Binomial-distribution/nascent/docs/implementation/codex-plans/README.md

# Codex B 层实施计划归档

这些文件来自本机 GPT Codex 会话，按时间从新到旧大致为：

| 文件 | 主题 |
|---|---|
| [`PR6-评审修复与页面层级定稿.md`](PR6-评审修复与页面层级定稿.md) | PR #6 Review 与身体笔记页面层级 |
| [`PR6-心率接入与身体笔记身心总结.md`](PR6-心率接入与身体笔记身心总结.md) | Health Connect 心率与身心三段总结（后续 PR） |
| [`B层信息架构纠正与完整纵向实现.md`](B层信息架构纠正与完整纵向实现.md) | 情景漫游 / 我的节奏拆分与完整 UI（后续 PR） |
| [`Android-心绪与亲密时刻框架.md`](Android-心绪与亲密时刻框架.md) | 历史 Flutter Android 骨架 |
| [`心绪与亲密时刻软件框架.md`](心绪与亲密时刻软件框架.md) | 历史 Flutter 三层导航骨架 |

当前口径以 [`../B层完整软件实施计划-B3.0.md`](../B层完整软件实施计划-B3.0.md) 和 [`../../architecture/B层完整版技术文稿-双模型与偏好闭环.md`](../../architecture/B层完整版技术文稿-双模型与偏好闭环.md) 为准。
