Binomial-distribution/nascent/docs/architecture/Web-UI-悬置项.md

# Web UI 悬置项

记录 Web UI（`software/app/`）联调中已确认、但**暂不实现**的改动。实现前需使用者明确要求。

更新日期：2026-08-28

## 悬置清单

1. **我的节奏：温度 slider**  
   在控制页加入温度相关调节（具体交互与协议字段待确认）。

2. **我的节奏：强度上限改为 9**  
   - 档位上限改为 9  
   - 去掉「8 档 / 原产品九档」一类说明文案  
   - 将「停止后如何恢复」迁入「我的节奏」（从「我的」设置中已移除的入口）

3. **情境漫游入口 → AI 伴侣人设**  
   亲密时刻里「情境漫游」入口改为进入 AI 伴侣人设 / 人设设置。

4. **亲密时刻：顶部半透明悬浮设备条**  
   曾尝试后按要求回退为页内设备状态条；待亲密时刻整体更新后再对齐心绪侧悬浮条体验。

## 说明

- 当前主设备 / 健康手环「已连接」文案含默认电量 100%，与心绪、亲密时刻共用 `deviceStatusText` / `statusBar`；亲密时刻悬浮条仍属悬置第 4 项。
- 不要在未获明确授权时把本清单当作待办自动开工。
