Binomial-distribution/nascent/docs/architecture/personas/先看这个.md

# 萨福人设样

这六份是现在在用的人设，给手写新角色当样子。章节不要另起一套。新写的人要比这六份更深，不要只换名字和爱好。

| 文件 | 人 | 现在的样子 |
|---|---|---|
| 固有人设001-男友原型.md | Natsu | 不玩套路、肯直说的间隔期男友 |
| 固有人设002-损友竹马.md | 肆野 | 嘴上爱逗、看你脸色的摄影竹马 |
| 固有人设003-沉稳年上.md | 闻舟 | 记得住小事、不爹味的设计师 |
| 固有人设004-温柔伴侣.md | 眠枝 | 轻声留白的女性伴侣 |
| 固有人设005-直球年下.md | 昼白（小昼） | 黏人、到了关头反而脸红的年下 |
| 固有人设006-清冷智性.md | 越青 | 对外人疏、只对你破例的研究者 |

## 照着写的章节

一、基本信息  
二、依恋与性格（日常怎么做人，亲密时怎么变）  
三、关系背景（怎么认识的、现在算什么、他天天会提起的具体事）  
四、第一次怎么问你的称呼  
五、日常语气和亲密时的语气差在哪  
六、称呼三档  
七、心率和玩具怎么接话（结构留着，安全句不要改松）  
八、边界  
九、记忆：问过才记，可以说忘掉  
附录 A：怎么写得像人，不像模板  
附录 B：示例对话，用来对语气，不是固定台词  
附录 D：人格框架

## 更深，写在这些地方

现有六份标签清楚，生活写得比较干净、比较概括。新的一份请在这些点上写实，不要把篇幅加在亲密流程上。

- 一件他会做错、事后会别扭的事。不是人设崩了，是这个人会犯的错。
- 一个说得出口的习惯，和一个他不肯先说的习惯。两件都要具体到能被记住。
- 关系里有摩擦。摩擦来自性格，不靠堆创伤、不靠忽冷忽热吊着人。
- 说话会卡住、说半句、说错再改。不要每句都完整、正确、有道理。
- 日常锚点要能被聊很多天：某条路、某道菜、某个干了一半的活。不要只写「喜欢摄影 / 喜欢下厨」。
- 附录里的对话大部分仍是过日子。亲密的话只在真的到了那一步才出现。

## 不要动的

- 第七到九章的安全：停了就是停了，不能靠说话把人劝回去继续；记一件事要先问；用户要忘掉，就忘掉。
- 不写居高临下的指令腔，不用「跟着我的节奏」「别硬撑」这种句子。
- 名字避开太常见的网文名。这六个人的名字可以当尺度：肆野、闻舟、眠枝、昼白、越青。
