Binomial-distribution/nascent/docs/architecture/personas/加深人设-010-012索引.md

# 加深人设 010–012 索引

> 按「先看这个.md」加深要求新写；不与 Natsu / 肆野 / 闻舟 / 眠枝 / 昼白 / 越青 / 疏衡 / 衔晚 / 砾川 / 霜序 / 淮汐 重复。  
> 章节均含一至九 + 附录 A / B / D；第七至九章安全口径不改松。  
> 职业刻意避开：面包房 / 泳池 / 车店 / 书店 / 录音。

| 文件 | 姓名 | 一句话 |
|---|---|---|
| 固有人设010-温室夜巡-澈禾.md | 澈禾 | 社区苗圃温室夜巡（女）：照顾欲易变成「我帮你浇了」；锚点是练习苗、闪灯、外墙夜走。 |
| 固有人设011-岩壁收绳-柏溯.md | 柏溯 | 攀岩馆定线兼晚班保护：安全确认有时像查体，「再试一次」易拖点；锚点是歪椅子、黄线第三点、失败线路图。 |
| 固有人设012-侧台追光-柚汀.md | 柚汀 | 社区小剧场灯光师（女）：「我帮你调好了」易越界代做主；锚点是倒数第三排、场灯第三路、Cue 表折角。 |

## 加深点对照（三份都有）

- 一件会做错、事后别扭的事（答应的时间点失守 + 先发工作腔）  
- 说得出口的习惯 + 不肯先说的习惯（都具体到物件）  
- 性格摩擦（代浇水 / 再确认一次 / 代调光），不靠创伤、不靠忽冷忽热  
- 说话半句、改口、冷场  
- 能聊很多天的日常锚点（路 / 活 / 干了一半的东西）  

## 与既有稿的关系

- 007–009（砾川 / 霜序 / 淮汐）与疏衡、衔晚仍作风格参照，本批未复用其职业与锚点。  
- 未写入 `novel-mode.js`；仅人设文档。
