Binomial-distribution/nascent/docs/implementation/codex-plans/PR6-评审修复与页面层级定稿.md

# PR #6 评审修复与页面层级定稿

> 归档来源：本机 GPT Codex 实施计划（2026-08-28）。历史方案，不以本文件覆盖 B3.0 权威规格。

## Summary

在当前分支 `feat/body-notes-insight` 上修复 PR #6 的全部评审问题，并按最新要求调整身体笔记页面。情景漫游本次只完善技术文档和页面契约，不在这个已经较大的 PR 中继续扩展完整 UI。

完成后运行完整检查，提交并推送到 PR #6，不合并 PR。

## Key Changes

### 身体笔记

- 保持三级结构：`记录列表 → 记录详情 → 微信式了解自己对话`。
- 记录详情改为单页纵向布局：
  - 顶部展示本次日期、模式、时长、数据质量和事实摘要。
  - 接着展示本次档位、压力和温感可视化。
  - 下方直接展示最近最多 5 次有效记录的对比图表和聚合总结。
  - 数据不足时显示明确说明，不推断偏好。
- 移除“只看这一次”和“参考近期记录”两个固定按钮及额外范围选择弹窗。
- 页面底部只保留一个“了解自己”入口。
- 点击入口即授权 Chat 9B 读取页面上明确列出的本次记录和近期记录；聊天页持续显示具体来源。
- 修复启动竞态：
  - 有后端请求能力时，加载完成前状态保持“未确定”。
  - 加载或后端状态未确定时，删除、保存发现和发起洞察等修改操作全部失败关闭。
  - UI 同步禁用相关按钮并显示加载状态。
  - 纯静态演示明确标记为离线状态，仍允许仅修改内存数据。
  - 后端加载完成后不能覆盖加载期间的本地操作，也不能让已删除记录复活。
- 所有模式名称统一通过安全回退获取，未知模式按 `free` 展示，避免 `MODE_UI[item.mode]` 抛出异常。

### B 层契约与后端

- 统一 Skill 契约：
  - 模板和 Chat Skill 使用 `rhythm_segment`、`set_pattern`。
  - `hold_current` 只属于 Control 9B 的控制决策，不作为模板硬件 Skill。
  - 文档不再把设备协议命令 `set_level` 当作 Agent Skill。
- 统一双模型名称：
  - `nascent-chat-9b` 是 Chat 逻辑角色别名。
  - `nascent-control-9b` 是 Control 逻辑角色别名。
  - 两者初期均可映射到供应商模型 `Qwen/Qwen3.5-9B`，但使用独立配置和超时。
  - `nascent-realtime-9b` 标记为已废弃的旧口径，不再用于新流程。
- 修复 `generate_control()`：
  - `hold` 决策保留模型原有 `reason_codes`。
  - `hold` 携带的 Skill、档位、Pattern 等建议字段全部清空。
  - 只有 `recommend` 决策才检查模板 Skill 白名单。
  - 不允许的推荐降级为 `hold + skill_not_allowed`。
  - 所有结果继续强制 `action=null`，不能直接生成设备命令。
- 重构身体洞察过滤：
  - 保留设备控制、医疗诊断和确定性偏好断言的禁止规则。
  - 删除对“固定偏好”的宽泛子串封禁。
  - 禁止“说明你喜欢”“证明你”“你一定”等确定性断言。
  - 允许“不代表固定偏好”等否定性安全说明。
  - 本地安全回退也必须经过 `BodyInsightModelOutput` 契约验证，不能绕过校验器。
- `/v1/agent/memory` 的 `limit` 使用 FastAPI 参数约束为 `1..20`，非法值返回 `422`；内存 Provider 再做一次防御性限制。

### 情景漫游文档层级

情景漫游入口页明确只有三个并列按钮：

1. `选择已有人设`
   展示以前创建或保存的人设；点击某个人设直接进入独立情景聊天页。
2. `定义人设`
   使用结构化表单设置名称、风格、语气和允许的 Skill；确认创建后直接进入情景聊天页。
3. `对话创建人设`
   进入专门的人设创建对话；生成并确认人设后，再跳转到真正的情景聊天页。

人设创建对话与实际情景使用必须是不同页面和路由。实际使用页采用类似微信的消息气泡界面，包含人设信息、连接状态、对话、语音入口和脱敏数据走向，但这部分 UI 编码留到后续独立短分支。

### 文档、缓存与 CI

- 更新 B 层架构文档、Prompt 契约、语音方案、后端 README 和 `.env.example` 注释，使 Skill、模型别名和删除接口一致。
- 删除接口文档以当前 `/v1/agent/...` 和 `/v1/body-notes/...` 为已实现接口；会话级删除草案明确标记为未来规划。
- Service Worker 缓存升级版本，并在 `activate` 阶段删除旧的 `nascent-shell-*` 缓存。
- 新增 GitHub Actions：
  - Python 3.11、Node.js 20。
  - 安装 `software/backend/requirements.txt`，确保 `pytest-asyncio` 存在。
  - 配置异步 fixture loop scope，避免 pytest 警告和异步测试静默跳过。
  - 执行前端 Node 测试、全部后端测试、Ruff、compileall、协议生成检查和 diff 检查。
- 实施文档记录 PR #6 修复结果，并将飞书 revision 91 同步列为合并后的待办，不声称仓库和飞书当前完全同步。

## Interfaces And Tests

- `GET /v1/agent/memory?limit=`：仅接受 `1..20`。
- 身体笔记不新增后端路由，继续使用显式 `session_id` 和 `comparison_session_ids`。
- 不修改 `protocol/contract.yaml`，因为本轮没有新增设备跨端字段。
- 新增回归测试：
  - 加载未完成时删除被拒绝，本地记录不消失。
  - 加载完成后删除必须调用后端，记录不会复活。
  - 无 Fetch 的静态演示仍支持本地删除。
  - `hold` 保留原因并清空非法推荐字段。
  - 非法 `recommend` 降级为 `skill_not_allowed`。
  - “不代表固定偏好”通过校验，确定性偏好断言被拒绝。
  - 本地洞察回退通过相同输出契约。
  - 负数、零和超过上限的记忆查询参数得到正确结果。
  - 未知会话模式不会导致详情页或聊天页崩溃。
- 浏览器验收覆盖 360×800 手机视口和桌面视口：详情页顺序正确、近期图表可见、只有一个“了解自己”入口、聊天来源清晰且无横向溢出。

## Git Delivery

- 在 `feat/body-notes-insight` 上显式暂存本次文件。
- 提交信息：`fix: address PR 6 review feedback`
- 推送到现有远程分支，更新 Draft PR #6。
- 在 PR 中回复每一项评审问题、测试结果和未实现的情景漫游 UI 范围。
- 不自动合并 PR。
