Binomial-distribution/nascent/hardware/toy-sidecar/docs/schematic.png

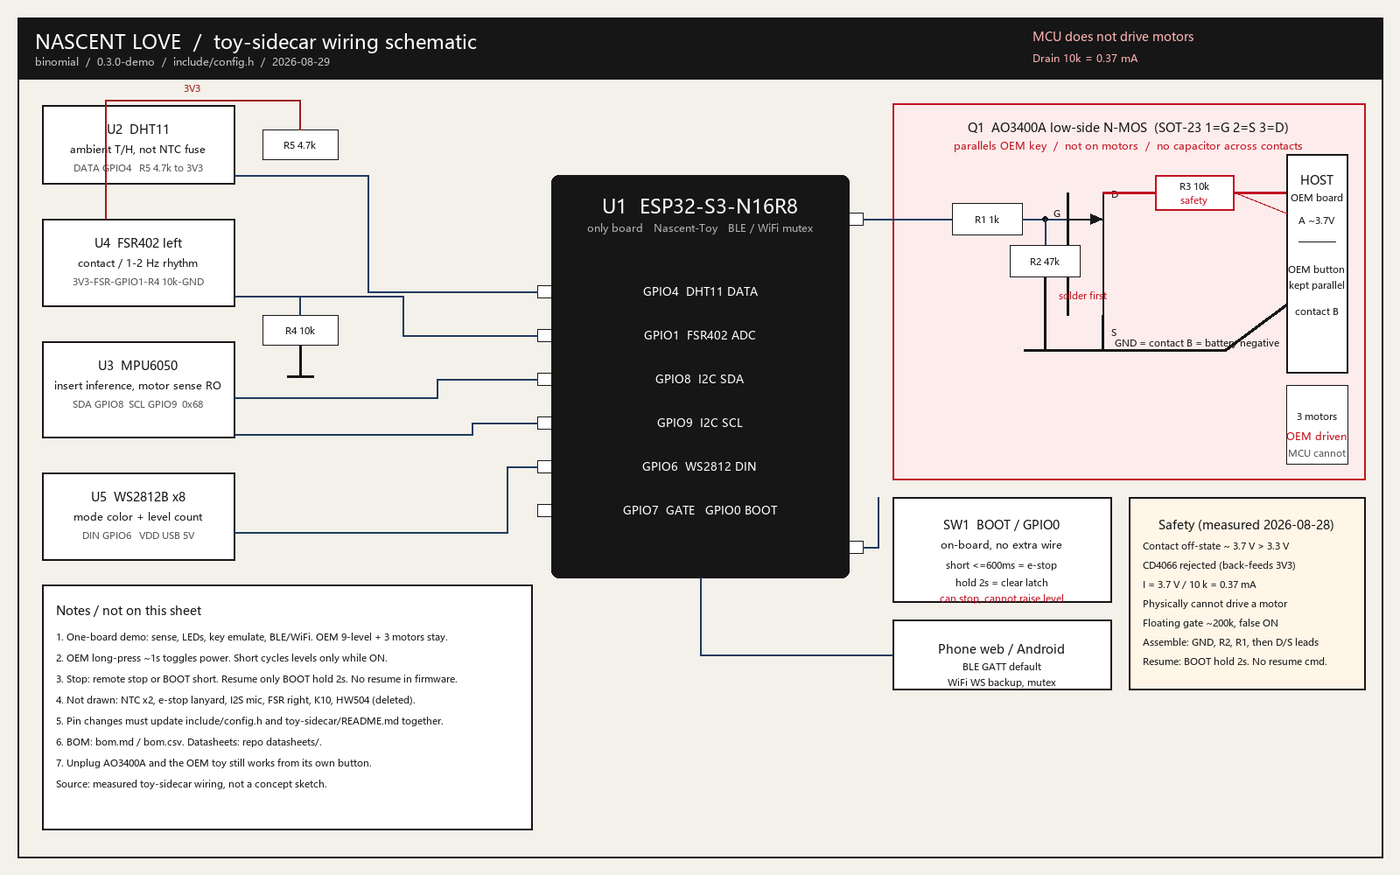
hardware/toy-sidecar/docs/schematic.png
