Binomial-distribution/nascent/www/img/hero-portrait.png

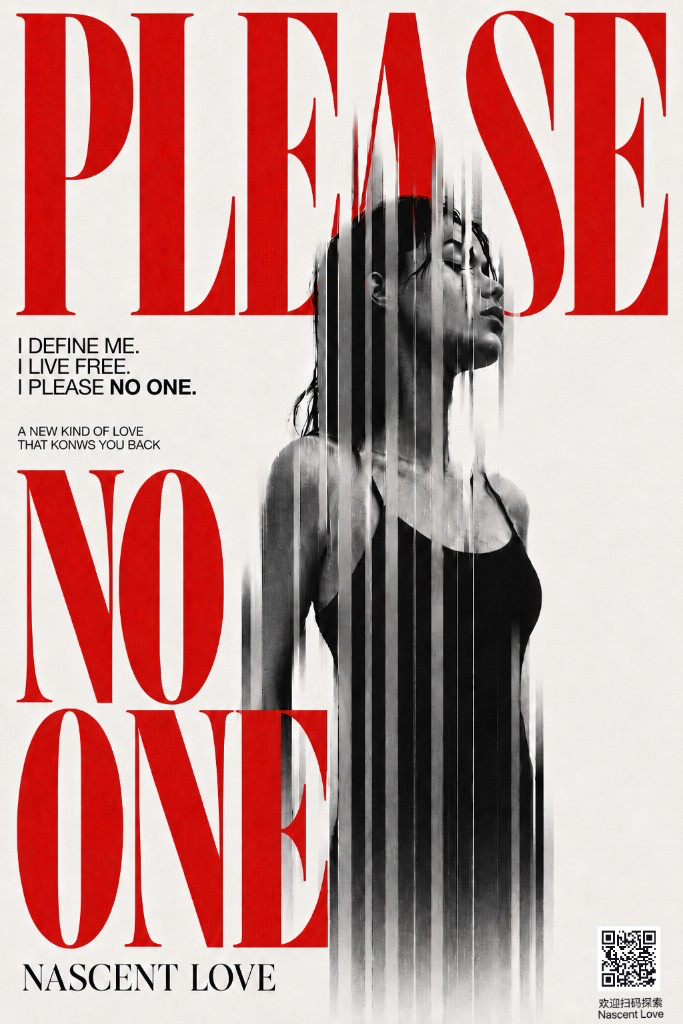
www/img/hero-portrait.png
