Binomial-distribution/nascent/hardware/toy-sidecar/docs/bom.md

# Nascent Love 验证期 BOM

团队 **binomial** · 项目 **Nascent Love** · 板卡 `hardware/toy-sidecar` · 协议 `0.3.0-demo`

验证期只有一块板：ESP32-S3-N16R8。它采集、推断、点灯，经 AO3400A 并联原产品按键；**不驱动电机**。电机、九档逻辑、实体按键都还在原产品控制板上。

单价为 2026-08 国内散件参考价（人民币），不含原产品本体。CSV 源：[`bom.csv`](bom.csv)。接线原理图：[`schematic.svg`](schematic.svg)。

## 采购件

| # | 位号 | 数量 | 型号 / 规格 | 封装 | 参考单价 | 小计 | 用途与约束 |
|---|---|---|---|---|---|---|---|
| 1 | U1 | 1 | ESP32-S3-N16R8 开发板（16MB Flash / 8MB PSRAM / USB-C） | DevKit | 48.00 | 48.00 | 玩具侧唯一主控。广播名 `Nascent-Toy`。板载 BOOT = GPIO0 |
| 2 | U2 | 1 | DHT11 温湿度模块 | 模块 | 4.00 | 4.00 | GPIO4 单总线。只做玩具环境温湿度，不参与接触熔断 |
| 3 | U3 | 1 | MPU6050（GY-521）六轴 | 模块 | 9.00 | 9.00 | I2C GPIO8/9，地址 0x68。入体推断；电机观测只读、永不驱动按键 |
| 4 | U4 | 1 | FSR402 圆膜压力 | 薄膜 | 22.00 | 22.00 | GPIO1 ADC。3V3—FSR—ADC—10k—GND。不做高潮检测 |
| 5 | U5 | 1 | WS2812B ×8 | 灯板 | 10.00 | 10.00 | GPIO6 RMT。建议 5V 供电。档位 = 点亮颗数 |
| 6 | Q1 | 1 | AO3400A 30V N-MOS | SOT-23 | 0.80 | 0.80 | 低边开关并联原按键。引脚 1=G / 2=S / 3=D |
| 7 | R1 | 1 | 1kΩ ±5% 1/8W | 直插 | 0.05 | 0.05 | GPIO7 到栅极串联 |
| 8 | R2 | 1 | 47kΩ ±5% 1/8W | 直插 | 0.05 | 0.05 | 栅极下拉。必须先于触点飞线焊接 |
| 9 | R3 | 1 | 10kΩ ±5% 1/8W | 直插 | 0.05 | 0.05 | **安全件**：漏极限流，支路 ≤0.37mA。不可省、不可减小 |
| 10 | R4 | 1 | 10kΩ ±5% 1/8W | 直插 | 0.05 | 0.05 | FSR402 下拉 |
| 11 | R5 | 1 | 4.7kΩ ±5% 1/8W | 直插 | 0.05 | 0.05 | DHT11 上拉；模块已带则可省 |
| 12 | W1 | 1 | 飞线 / 杜邦线 | 套 | 6.00 | 6.00 | 原按键触点走焊接飞线，不要走面包板 |
| 13 | J1 | 1 | USB-C 数据线 | 线材 | 8.00 | 8.00 | 供电与烧录 |
| 14 | SW1 | 1 | BOOT 键 | 板载 | 0 | 0 | 短按急停，长按 2s 解闩锁。无需外购外接 |

**电子件小计约 ¥108。** 不含原产品本体。

## 宿主（不采购进本 BOM）

| 位号 | 名称 | 说明 |
|---|---|---|
| HOST | 萨福入体震动棒原产品 | 原控制板九档逻辑 + 实体按键 + 三路振动。本板只并联按键。摘掉 AO3400A 支路后原产品仍可独立使用 |

## 验证期未焊（量产项，不要按本表采购来演示）

| 器件 | 原因 |
|---|---|
| NTC ×2（接触面 + 外壳） | 12Hz 接触过温熔断。Demo 未焊；DHT11 不能替代 |
| FSR402 右（GPIO2） | `TOY_HAS_FSR_R=0`，固件不读 |
| 常闭急停拉环 | Demo 用板载 BOOT 键短按代劳 |
| I2S 麦克风 | 本地安全词。Demo 可不焊 |
| HW504 摇杆 / 行空板 K10 | 协议 0.3.0 已删除，不要再买 |

## 引脚（与 `include/config.h` 一致）

| 功能 | 引脚 | 外围 |
|---|---|---|
| DHT11 DATA | GPIO4 | R5 4.7k 上拉到 3V3 |
| FSR402 左 | GPIO1 | R4 10k 下拉到 GND |
| FSR402 右 | GPIO2 | 未接 |
| WS2812B DIN | GPIO6 | 灯珠 5V，地与开发板共地 |
| AO3400A 栅极 | GPIO7 | R1 1k 串联 + R2 47k 下拉 |
| MPU6050 SDA | GPIO8 | 模块内部上拉，100kHz |
| MPU6050 SCL | GPIO9 | |
| BOOT | GPIO0 | 板载，不接线 |

AO3400A：漏极经 R3 10k 接原按键触点 A（关机态约 3.7V）；源极接触点 B + 原电池负极 + ESP32 GND（三方共地）。原实体按钮保留并联。

Datasheet 目录：[`../../../datasheets/`](../../../datasheets/README.md)。
