Binomial-distribution/nascent/hardware/toy-sidecar/src/ble_peripheral.cpp

#include "ble_peripheral.h"

#include <Arduino.h>
#include <BLE2902.h>
#include <BLEDevice.h>
#include <BLEServer.h>
#include <BLEUtils.h>

namespace {

BLEServer *g_server = nullptr;
BLECharacteristic *g_uplink = nullptr;
BLECharacteristic *g_downlink = nullptr;
BLECharacteristic *g_info = nullptr;
BlePeripheral *g_self = nullptr;

}  // namespace

class NlServerCallbacks : public BLEServerCallbacks {
  void onConnect(BLEServer *) override { g_self->handleConnect(millis()); }
  void onDisconnect(BLEServer *server) override {
    g_self->handleDisconnect();
    // 必须重开广播，否则断一次就再也连不上。
    // 注意这**不代表**断连无害：up() 会立刻转 false，安全总督随即归零。
    // 重开广播只是让人能连回来，不是让输出继续。
    server->startAdvertising();
  }
};

class NlDownlinkCallbacks : public BLECharacteristicCallbacks {
  void onWrite(BLECharacteristic *ch) override {
    // 2.x 返回 std::string，3.x 返回 Arduino String，两者都有 c_str/length。
    auto v = ch->getValue();
    g_self->handleWrite(v.c_str(), v.length(), millis());
  }
};

bool BlePeripheral::begin(CommandHandler handler) {
  if (started_) return true;
  handler_ = handler;
  g_self = this;

  BLEDevice::init(NL_BLE_DEVICE_NAME);
  // contract 的 min_mtu=185 是下限，不是上限。一帧 BleUplink JSON 大约 210 字节，
  // ATT 载荷还要扣 3 字节：把本地 MTU 钉在 185，协商结果就装不下，notify 会失败，
  // 于是 App 只拿到 Info 令牌、永远看不到遥测。ESP32 允许的上限是 517。
  BLEDevice::setMTU(517);

  g_server = BLEDevice::createServer();
  g_server->setCallbacks(new NlServerCallbacks());

  // 三个特征加上 CCCD 描述符，默认的 15 个句柄不够用。
  BLEService *svc = g_server->createService(BLEUUID(NL_BLE_SERVICE_UUID), 32, 0);

  // Notify 是正路。Windows Chrome 有时订了 CCCD 仍不推事件，可读一次最新值作退路。
  g_uplink = svc->createCharacteristic(
      NL_BLE_UPLINK_UUID,
      BLECharacteristic::PROPERTY_NOTIFY | BLECharacteristic::PROPERTY_READ);
  g_uplink->addDescriptor(new BLE2902());

  g_downlink = svc->createCharacteristic(NL_BLE_DOWNLINK_UUID, BLECharacteristic::PROPERTY_WRITE);
  g_downlink->setCallbacks(new NlDownlinkCallbacks());

  g_info = svc->createCharacteristic(NL_BLE_INFO_UUID, BLECharacteristic::PROPERTY_READ);

  svc->start();
  publishInfo();

  BLEAdvertising *adv = BLEDevice::getAdvertising();
  adv->addServiceUUID(NL_BLE_SERVICE_UUID);
  adv->setScanResponse(true);
  BLEDevice::startAdvertising();

  started_ = true;
  Serial.printf("[ble] 广播 %s，服务 %s\n", NL_BLE_DEVICE_NAME, NL_BLE_SERVICE_UUID);
  return true;
}

void BlePeripheral::end() {
  if (!started_) return;
  // 切到 WiFi 之前必须把射频和协议栈整个还掉，否则两栈并存抢时隙。
  BLEDevice::deinit(true);
  g_server = nullptr;
  g_uplink = nullptr;
  g_downlink = nullptr;
  g_info = nullptr;
  started_ = false;
  connected_ = false;
  gate_.endSession();
  Serial.println("[ble] 已停止");
}

void BlePeripheral::tick(uint32_t) {
  // Bluedroid 的连接维护全在它自己的任务里，这里没有要推进的状态。
}

bool BlePeripheral::up(uint32_t) const { return connected_; }

void BlePeripheral::sendUplink(const char *json, size_t len) {
  if (!connected_ || !g_uplink || json == nullptr || len == 0) return;

  uint16_t peer_mtu = 23;
  if (g_server != nullptr) {
    uint16_t m = g_server->getPeerMTU(g_server->getConnId());
    if (m >= 23) peer_mtu = m;
  }
  const uint16_t max_payload = peer_mtu > 3 ? static_cast<uint16_t>(peer_mtu - 3) : 20;
  // peer MTU 仍是 23 时多半还在协商，硬丢会让 Windows 永远等不到第一帧。
  // 已经协商到一个明确偏小的值（例如曾经的 185）才跳过，避免发截断 JSON。
  if (peer_mtu > 23 && len > max_payload) {
    static uint32_t last_warn_ms = 0;
    uint32_t now = millis();
    if (now - last_warn_ms > 2000) {
      last_warn_ms = now;
      Serial.printf("[ble] 上行 %u 字节 > MTU 载荷 %u（peer MTU %u），本帧丢弃\n",
                    static_cast<unsigned>(len), static_cast<unsigned>(max_payload),
                    static_cast<unsigned>(peer_mtu));
    }
    return;
  }

  g_uplink->setValue(reinterpret_cast<uint8_t *>(const_cast<char *>(json)), len);
  g_uplink->notify();
  static bool logged_ok = false;
  if (!logged_ok) {
    logged_ok = true;
    Serial.printf("[ble] 首帧上行已 notify，%u 字节，peer MTU %u\n",
                  static_cast<unsigned>(len), static_cast<unsigned>(peer_mtu));
  }
}

void BlePeripheral::handleConnect(uint32_t now_ms) {
  connected_ = true;
  gate_.newSession(now_ms);
  publishInfo();
  uint16_t peer = g_server ? g_server->getPeerMTU(g_server->getConnId()) : 0;
  Serial.printf("[ble] 手机已连接，已签发新会话令牌；peer MTU %u（本地上限 %u）\n",
                static_cast<unsigned>(peer), static_cast<unsigned>(BLEDevice::getMTU()));
}

void BlePeripheral::handleDisconnect() {
  connected_ = false;
  gate_.endSession();
  Serial.println("[ble] 手机断开");
}

void BlePeripheral::publishInfo() {
  if (!g_info) return;
  char buf[128];
  size_t n = gate_.buildInfo(buf, sizeof(buf));
  g_info->setValue(reinterpret_cast<uint8_t *>(buf), n);
}

void BlePeripheral::handleWrite(const char *data, size_t len, uint32_t now_ms) {
  // 本函数在 Bluedroid 任务里跑。handler_ 只允许把指令丢进信箱，
  // 不能在这里动按键或总督，见 main.cpp 的 CommandMailbox。
  nl_command_t out;
  if (!gate_.accept(data, len, now_ms, out)) return;
  if (handler_) handler_(out);
}
