Binomial-distribution/nascent/hardware/toy-sidecar/src/ao3400.h

// AO3400A 低边 N-MOS：并联原产品的轻触按键。
//
// 边界必须记清楚：
//   - 它只"按按钮"，**不驱动电机**。电机始终由原产品控制板驱动。
//   - 漏极串了 10kΩ，这条支路的电流被封在 0.37mA（3.7V / 10kΩ）。
//     那颗电阻是安全论证的一部分，不是可选件：AO3400A 本体能过 5.7A，
//     拆掉它就等于把"物理上无法驱动电机"这条保证降级成一句口头纪律。
//     原板按键节点是兆欧级高阻输入（实测 200kΩ 即可触发），10kΩ 导通时
//     只在节点上留约 80mV，对功能毫无影响。
//   - 栅极必须有 47kΩ 下拉。浮空栅极实测半导通约 200kΩ，足以误触发开机。
//   - 原实体按钮不拆，手按和软件按并存。
//
// 原板行为模型（2026-08-28 实物实测，不再是假设）：
//   - 长按约 1s = 电源**取反**。关机态长按 → 开机并停在第 1 档；
//     开机态长按 → 关机。它不是单向的"关机键"，这一点决定了整个状态机。
//   - 短按 = 档位循环，**仅开机态有效**；关机态短按原板毫无反应。
//   - 原板不回传任何状态，所以下面的 powered_ / step_ 都是开环假设。
//     唯一可信的已知点是"关机"：一次把它关掉的长按之后，记录才重新对齐。
#pragma once

#include <stdint.h>

class Ao3400 {
 public:
  void begin(uint8_t pin);

  // BLE / WiFi 初始化之后调用：把栅极脚重新声明为输出。
  // 无线电协议栈有时会改 GPIO 复用，外部 3.3V 能触发、固件却拉不动时就是这个。
  void reclaimPin();

  // 每轮主循环调用，推进按键时序状态机。
  void tick(uint32_t now_ms);

  // 请求原板停在第 target 档（1..9，对应协议档位）。0 表示正常关机。
  // 内部自己算怎么按，调用方不需要关心原板当前在哪一档。
  void requestLevel(uint8_t target);

  // 联调用：直接发一次原按键时序，不走开环档位状态机。
  // hold=true 长按约 1.2s（电源取反）；false 点按约 120ms（开机后切一档）。
  void requestRawPress(bool hold);

  // 立即关机。停机路径专用。
  //
  // 注意它在"记录为关机"时**什么都不按**：长按是电源取反，
  // 盲发一次会把用户没要求的输出打开，那是这个产品最坏的失败模式。
  void requestOffNow();

  bool busy() const { return goal_active_ || phase_ != Phase::kIdle; }
  uint8_t assumed_step() const { return step_; }
  bool powered() const { return powered_; }
  bool needs_resync() const { return needs_resync_; }

  // IMU 电机观测器修正开环记录的唯一入口。
  //
  // 它**只改记录，不入队任何按键**。观测不能变成动作：让一个会被
  // 人体动作干扰的信号去直接按电源键，等于把"设备自己动起来"的
  // 权力交给噪声。修正之后，是否真的去按仍由 stop / requestLevel 决定。
  void markObservedPowered(bool on);

  // 开环跟踪难免会跑偏。人工按了实体按钮之后调用这个重新对齐。
  void resync() { needs_resync_ = true; }

 private:
  enum class Phase : uint8_t { kIdle, kPressing, kGap };

  void startPress(bool long_press, uint32_t now_ms);
  void finishPress();

  uint8_t pin_ = 0;
  Phase phase_ = Phase::kIdle;
  uint32_t phase_until_ms_ = 0;
  bool pressing_long_ = false;  // 正在执行的这一下是长按吗，决定时长与效果

  // 目标式而不是队列式：不预先算"要按几下"，而是每按完一下都用最新的
  // 开环状态重新决策。这样新指令半路插进来也不会让次数失配。
  bool goal_active_ = false;
  uint8_t goal_step_ = 0;
  uint8_t press_budget_ = 0;  // 一个目标最多按这么多下，防止跑飞后无限按

  uint8_t step_ = 0;  // 开环假设的原板当前档位，0 = 关机
  bool powered_ = false;
  bool needs_resync_ = false;
  bool raw_queued_ = false;
  bool raw_hold_ = false;

  // 临界区里不能 printf。tick 退出后再打。
  bool log_high_ = false;
  bool log_low_ = false;
};
