Binomial-distribution/nascent/(commit log)

2026-08-27 初始化 Nascent 单仓：协议契约、双板固件、App 与后端骨架
    以 protocol/contract.yaml 为三端唯一事实来源，由 tools/gen.py 生成
    C / Dart / Python 产物并直接投放到各端包内，避免手工同步造成漂移。
    固件的通用驱动一律用社区成熟库，源码 vendored 在 hardware/*/lib/
    （DHTesp、MPU6050、Adafruit_NeoPixel、ArduinoJson），来源与版本记在
    hardware/VENDOR.md。自己写的只有产品独有逻辑：入体推断、灯语优先级、
    CD4066 对原板的按键时序、板间协议。K10 侧的屏幕与按键 API 照着
    DFRobot 官方示例写，示例原件留在 reference/ 下备查。
    安全边界贯穿四层：CD4066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
2026-08-27 docs: 补充协作规范与 AI 入口
    把短分支、显式暂存、协议生成流程和高风险评审写成仓库内规范，
    并用 AGENTS.md 要求开发任务开始前先读这份文档。
2026-08-27 Update Nascent 开发与代码提交规范.md
2026-08-27 docs: 把飞书产品架构归档进仓库
    飞书只作讨论草稿。权威副本放在 docs/architecture/，开发手册约定
    改架构必须同步进本仓库并走 PR，不能只改飞书。
2026-08-28 feat: add heart and intimacy app framework
2026-08-28 docs: record app framework delivery
2026-08-28 fix: 修复评审发现的版本门控与控制页状态问题
    - BLE 版本门控放宽为只校验主版本，0.1.x 旧固件无需重新烧录即可连接；
    VERSION_MINOR 同步为 2 并重新生成三端协议产物
    - 控制页草稿档位在上行确认后交回设备值，停止时立即清除，
    避免设备已停而界面仍显示非零档位
    - 连续记录天数对"今天还没记"留宽限，从昨天开始计数，并补边界测试
    - 空白身体笔记不再提示已保存；情境漫游首次点按停留在首段；
    心绪选择器改为均分宽度避免窄屏溢出
    - 抽取心绪页与亲密时刻页共用的 DeviceStatusBar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
    [contract.yaml]
2026-08-28 docs: 归档飞书心绪层实现与 UI 设计定稿
    - 新增 docs/architecture/心绪层技术实现.md（飞书 revision 2）
    - 新增 docs/architecture/UI设计与用户旅程.md（飞书 revision 8）
    - 产品架构.md 的来源列表链接到仓库内归档副本
    - 软硬件技术架构文档（FggRdEmySofDoGx2WzFc77MznCd）仍为 revision 63，
    与已有归档一致，无需更新
2026-08-28 feat: 控制端改为网站，并加同一套 Web UI 的 App 壳
    网站用 Web Bluetooth 直连行空板；Android App 加载同一页面、走原生 GATT。安全总督仍在浏览器侧。
2026-08-28 docs: 产品架构 V1.3 已反向同步回飞书原文（revision 75）
2026-08-28 fix: 原板按键改为长按取反语义，上电不再盲发长按
    实测原按键：长按约 1s 是电源取反而不是关机，短按只在开机态有效。原来 begin() 里那次"对齐用"的长按会把关着的玩具打开，属于停机路径上的实际风险。状态机改为目标式，每按完一下用最新开环状态重新决策并带按键预算上限，降档走关机再开机以避免绕经原板第 9 档。触点实测 3.7V 超过 3.3V，CD4066 供电冻结为情况 B：原板 3.8V 供电、三方共地、GPIO7 串 1kΩ。另新增只读的 IMU 电机观测器补开环盲区，观测只修正记录与报警、永不驱动按键，阈值待实物标定故默认关闭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
    [cd4066.cpp, cd4066.h, config.h, contract.yaml, main.cpp, motor_sense.cpp, motor_sense.h]
2026-08-28 docs: 记录架构文档反向同步至飞书 revision 91 (#5)
    PR #4 引入的 CD4066 供电定案（情况 B）、按键语义与固件状态机、
    电机观测器章节已写回飞书原文，37 项内容校验全部通过。
2026-08-28 原按键开关器件改为 AO3400A 低边 N-MOS（漏极串 10kΩ 限流） (#7)
    * refactor: 原按键开关由 CD4066 换为 AO3400A 低边 N-MOS
    触点实测 3.7V 高于 3.3V，CD4066 需要供电轨、且会经输入保护二极管往
    ESP32 的 3V3 轨倒灌，整条路线（原「情况 A / 情况 B」）作废。AO3400A
    源极即地，不需要供电轨也没有倒灌路径，栅极天然吃 3.3V 逻辑。
    漏极串 10kΩ 是为了把「本板不驱动电机」这条不变量继续保持在硬件级：
    CD4066 的 10mA 上限原本是物理保证，而 AO3400A 能过 5.7A。原板按键
    节点是兆欧级高阻输入（实测 200kΩ 即可触发），10kΩ 导通时只留约 80mV，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
2026-08-28 docs: 入库 AO3400A 厂商 datasheet，并以规格书修正阈值与导通电阻引用 (#8)
2026-08-28 docs: 记录架构文档反向同步至飞书 revision 127 (#9)
    * feat(protocol): 手机直连玩具侧，删除 K10 与摇杆相关契约
    去掉行空板 K10 与 HW504 摇杆之后，手机直接连玩具侧 ESP32-S3：
    BLE 优先，WiFi WebSocket 备用，两条承载同一份 JSON。
    破坏性变更：cmd 枚举删掉中间的 set_joystick，resume 线序由 6 前移到 5，
    固件与控制端必须同批更新。现场无已发出设备。
    最重要的一条是 resume：手机直连之后，"指令只可能来自 K10 物理按键"这个
    前提消失了。若继续让固件的 onCommand 接受 resume，手机就能远程解除停机
    闩锁——这是全系统最坏的失败模式。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
2026-08-28 docs: 记录规格书数值修正反向同步至飞书 revision 131 (#10)
    PR #8 入库 AO3400A 厂商 datasheet 后按规格书修正的三处引用
    （Vgs(th) 1.05/1.45V、Rds(on) < 48mΩ、datasheet 清单与未决表）
    已同步回飞书原文。
2026-08-28 feat(app): Web UI 设置与 Onboarding，并记录亲密时刻悬置项 (#12)
    完善「我的」安全与隐私/通用设置、安全词与设备电量展示，加入首次引导流；将暂不实现的亲密时刻相关改动写入悬置笔记以便后续接续。
2026-08-28 feat: 去掉行空板，手机直连玩具侧（BLE 默认 / WiFi 备用） (#11)
    * feat(toy-sidecar): WiFi WebSocket 备用通道，与 BLE 运行时互斥
    玩具侧作 STA 接入局域网并起 WebSocket 服务端，承载与 BLE 完全相同的 JSON。
    默认仍优先 BLE；当前通道空闲超过 TRANSPORT_IDLE_SWITCH_MS 且另一条可用才切，
    切过去起不来就退回来。同一时刻只开一条——ESP32-S3 只有一路 2.4GHz 射频，
    共存要靠时分，12Hz 上行会抖，而这条链路上跑着停机指令。
    顺手把下行的鉴权与拒绝规则抽成 downlink_gate，两条传输共用同一份，而不是
    在 WiFi 里再抄一遍 BLE 那 90 行。这些规则就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
2026-08-28 feat: add body notes insight and parallel agents (#6)
    * feat: add B-layer agent and body notes architecture
    * feat: add body notes insight flow
    * docs: adopt B3.0 spec and close PR #6 review findings
    * docs: link B3.0 implementation plan from architecture and README
    * docs: archive Codex B-layer plans alongside the B3.0 spec
    * fix: close leftover PR #6 review gaps in Skill docs and body-note races
    Agent Skill names, model alias mapping, and the two small bugs (load/delete resurrection, insight filter vs stub) now match the code; search_memor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
2026-08-28 feat: 四栏底栏，亲密时刻与身心记录分层 (#15)
    Keep intimacy to scenario personas plus self-control, move body notes onto a records long page, and redirect the old notes routes without merging into PR #6.
2026-08-29 feat(app): onboarding 蓝牙说明与健康手环配对 (#17)
    接上最新 main 后，更新权限页蓝牙文案，并在玩具配对后增加可跳过的健康手环配对；改动说明写入 Web-UI 改动笔记。
2026-08-29 feat: 情景人设改为女性向陪伴，并接上问卷建卡与自然语音
    情景列表改为顾深 / 阿北 / 阿月；问卷与手写建卡；通话先响铃再接通。Chat 每轮带 tts_style，MiniMax 走 emotion，设置页可切小米 MiMo。自定义声线本轮只在本机记下。一并修掉高潮误判、清除本地后对话/人设复活，以及 healthz 的 tts 字段。
2026-08-29 feat(app): onboarding 意图与陪伴者问卷 (#19)
    * feat(app): onboarding 意图与陪伴者问卷，合并经验与人设步骤
    用选择题替换原使用经验文案与自由填写人设，并补上节奏、保养提醒与隐私安心项；同步写入改动笔记，并修复 sw.js 残留冲突标记。
    * fix(app): 产品文案与陪伴者步骤「稍后设置」
    产品页去掉「萨福」字样；陪伴者过渡/性格/节奏均可稍后设置并跳到清洁提醒，清洁页保持必选。
    ---------
2026-08-29 feat(app): 小米手环 7 心率接入（AI 对话，不控机） (#18)
    验证期需要实时 BPM，但心率只能作为对话趋势，不能改 GATT 或调档。
    Android 壳收签名权限广播，网页做平滑与基线后写入已有 sensor_context。
2026-08-29 feat: 设置页给玩具配 WiFi，并准备后端 secrets 目录 (#21)
    非开发者经已鉴权的 set_wifi 写入 NVS，网站/PWA/Android 共用同一套设置页。
    部署密钥约定放到 software/backend/secrets/，真实密钥不进仓库。
2026-08-29 feat: 硬件联调页与玩具侧验板 (#23)
    * checkpoint before checking out chore/hw-local-config
    * feat(app): 将硬件联调入口放到「我的」最下方
    调试页不再夹在设备列表中间，滚动到设置页底部再进联调。
    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
2026-08-29 fix: 打通 Android 设备控制与九档情景自动调节
    将 Android BLE 连接状态机、共享 Web UI 的设备 Session/Governor/sendCommand，以及协议/固件目标档位 1–9 一并收口到当前已能真机调试的版本。产品页与硬件调试共用 GPIO7 长按开关；情景自动调节按开场授权后的 Control 建议下发。
    [ao3400.cpp, ao3400.h, contract.yaml, downlink_gate.cpp]
2026-08-29 fix(app): onboarding 结束后勿因完成礼重挂引导 (#26)
    完成礼写入心绪卡会同步触发 render；若仍停在 #/onboarding 会再次 mount 并把主界面挡住。先改 hash，并在已完成时放行 early-return。
2026-08-29 feat: 点人设先来电，左滑接通后上滑进文字聊 (#22)
    * feat: 情景默认文字陪伴，通话上滑进文字聊
    选人设后进文字 IM，窗口外轮次压进摘要，记忆需确认。通话接通后上层实时字幕、下层气泡，上滑进入完整聊天。
    * feat: 点人设先来电，左滑接通后上滑进文字聊
    去掉同屏聊天预览。设置里的自定义人设仍走保存/使用，不跳到来电。
    * fix: 离开通话停麦，接通后可改用文字并恢复播报
    离开通话页时停掉实时麦，进文字聊的定时器可取消；忘掉记忆后清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
2026-08-29 feat: 记录页加近期睡眠摘要 (#24)
    * feat: 记录页加近期睡眠摘要，用心绪与本机夜间心率对照
    * fix: 睡眠对照用醒来那天，时长只计有心率的时段
    夜间日志与心情按 7 个日历日裁剪并写回本机；nascent.hr.nights 不进 Chat 9B。
    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
2026-08-29 feat: 固定人设接入固有人设 001（陆聿） (#25)
    * feat: 固定人设接入固有人设 001（陆聿）完整 system prompt
    把男友原型可读文档与可执行 prompt 放进仓库，gentle 预设发送完整 system_prompt，后端优先使用并保留 sensor_context 硬约束。
    * fix: 陆聿 prompt 改由服务端持有，忽略客户端 system_prompt
    固定 SYSTEM_PROMPT 始终在前；gentle/001 由后端拼接人设正文，turn 不再上传整份 prompt。
    * feat: Natsu 人设 v2，并整理情景 UI 与 Agent 联调
    同步固有人设 001 可读文档与 system prompt v2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
2026-08-29 feat: 设置里用插件把设备交给用户自己的 AI (#28)
    * feat: 设置里用插件把设备交给用户自己的 AI
    用户侧叫「连接我的 AI」，底层才是 MCP。建议仍过 App 总督，不停机恢复，也不改设备契约。
    * test: 插件越界用例跟上协议档位上限
    主仓已把 LEVEL_MAX 改为 9，写死第 8 档不再能证明「越界丢弃不钳位」。
    * fix: 插件建议强制走总督，过期档不跳，SW 跟上新模块
    PWA 外壳仍是 v30 时 import ai-plugin.js 会 404；轮询在 applying 置位前会重复执行同一条建议；完成结果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
2026-08-29 docs: 加入验证期 BOM 与接线原理图，供硬件赛道评审引用 (#30)
    [bom.csv]
2026-08-29 feat: swipe to hide personas and restore them in settings (#32)
    Preset rows write hiddenKeys instead of deleting Natsu, with a settings restore list. Companion-only still skips ringing into text chat; automation authorization still goes through the call flow.
2026-10-25 docs: add deepened personas 007–012 and rewrite builtin novels
    Add the eight deepened persona sheets, their indexes, and the writing guide. Place the rewritten novel-mode.js so built-in shorts 001–006 follow each voice, while 《灯还没关》 and 《末班车到站以后》 stay as they are.
